marcosdxt/allprint-capboard/Outputs/BOM/Bill of Materials-ALLPRINT-CAPBOARD-677512.xlsx

Comment | Description | Designator | Footprint | LibRef | Quantity | LCSC
10uF/50V | 50V 10uF X5R ±10% 1206 Multilayer Ceramic Capacitors MLCC - SMD/SMT ROHS | C1, C16, C17, C46, C49 | CAP-0805 | CAP-10uF/50V-0805-X5R-MLCC | 5 | C13585
100nF/50V | 50V 100nF X7R ±10% 0603 Multilayer Ceramic Capacitors MLCC - SMD/SMT ROHS | C2, C3, C4, C5, C6, C12, C15, C18, C22, C24, C28, C29, C31, C37, C40, C48, C52, C71 | CAP-0603 | CAP-100nF/50V-0603-X7R-MLCC | 18 | C14663
1uF/25V | 25V 1uF X7R ±10% 0603 Multilayer Ceramic Capacitors MLCC - SMD/SMT ROHS | C7, C9 | CAP-0603 | CAP-1uF/25V-0603-X7R-MLCC | 2 | C29936
10nF/50V | 50V 10nF X7R ±10% 0603 Multilayer Ceramic Capacitors MLCC - SMD/SMT ROHS | C8, C19, C55, C61, C64, C66, C68, C70 | CAP-0603 | CAP-10nF/50V-0603-X7R-MLCC | 8 | C1589
15pF/50V | 50V 15pF NP0 ±5% 0603 Ceramic Capacitors RoHS | C10, C11 | CAP-0603 | CAP-15pF/50V-0603-NP0-MLCC | 2 | C107037
39pF/50V | 50V 39pF X7R ±10% 0603 Multilayer Ceramic Capacitors MLCC - SMD/SMT ROHS | C13, C14, C30, C32, C33, C34, C35, C36, C54, C60, C63, C65, C67, C69 | CAP-0603 | CAP-39pF/50V-0603-X7R-MLCC | 14 | C107049
10uF/16V | 16V 10uF X5R ±20% 0603 Multilayer Ceramic Capacitors MLCC - SMD/SMT ROHS | C20, C21, C23 | CAP-0603 | CAP-10uF/16V-0603-X5R | 3 | C92487
10uF/25V | 25V 10uF X5R ±10% 0805 Ceramic Capacitors ROHS | C25, C26, C27 | CAP-0805 | CAP-10uF/25V-0805-X5R-MLCC | 3 | C15850
220nF/50V | 50V 220nF X7R ±10% 0603 Multilayer Ceramic Capacitors MLCC - SMD/SMT ROHS | C38, C44, C45, C57, C58 | CAP-0603 | CAP-220nF/50V-0603-X7R-MLCC | 5 | C64705
1000uF | 1000uF 35V ±20% Through Hole,D10xL20mm Aluminum Electrolytic Capacitors RoHS | C39 | CAP-ELET-D10-H20 | CAP-1000uF-35V-D10-H20 | 1 | C398835
470nF/50V | 50V 470nF X7R ±10% 0603 Multilayer Ceramic Capacitors MLCC - SMD/SMT ROHS | C41, C50, C53 | CAP-0603 | CAP-470nF/50V-0603-X7R-MLCC | 3 | C513577
22nF/100V | 100V 22nF X7R ±10% 0805 Ceramic Capacitors RoHS | C42 | CAP-0805 | CAP-22nF/100V-0805-X7R-MLCC | 1 | C107137
1nF/100V | 100V 1nF NP0 ±5% 0805 Ceramic Capacitors RoHS | C43, C47, C56, C59 | CAP-0805 | CAP-1nF/100V-0805-NP0-MLCC | 4 | C326940
2.2nF/50V | 50V 2.2nF X7R ±10% 0603 Ceramic Capacitors RoHS | C51, C62 | CAP-0603 | CAP-2.2nF/50V-0603-X7R-MLCC | 2 | C107082
SM712.TCT-ES | 400W@8/20us Bidirectional SOT-23 ESD and Surge Protection (TVS/ESD) ROHS | D1, D2, D7, D8 | SOT23-3 | SM712.TCT-ES | 4 | C22363671
SMBJ15CA | 24.6A 600W@8/20us 24.4V 19.2V Bidirectional 15V SMB(DO-214AA) ESD and Surge Protection (TVS/ESD) ROHS | D3 | DO214-AA | SMBJ15CA | 1 | C2760879
SMBJ26CA | 28.9V 26V 42.1V 14.2A 600W Bidirectional DO-214AA(SMB) TVS Diodes RoHS | D4, D26 | DO214-AA | SMBJ26CA | 2 | C908854
MBRS360BT3G | 125A 60V 630mV@3A 3A SMB(DO-214AA) Single Diodes RoHS | D5 | DO214-AA | DIODE-SCHOTTKY-60V-3A-MBRS360BT3G | 1 | C59027
SMBJ5.0A | 65.3A 600W 9.2V 6.4V Unidirectional 5V DO-214AA TVS Diodes RoHS | D6 | DO214-AA | SMBJ5.0A | 1 | C83333
BZT52C15 | DIODO ZENER 15V-500mW-SOD123 | D9, D11 | SOD123 | BZT52C15 | 2 | C266569
SMAJ26A | 28.9V 26V 9.5A 42.1V 400W Unidirectional DO-214AC(SMA) TVS Diodes RoHS | D10, D12 | DO214-AC (SMA) | SMAJ26A | 2 | C2848697
1N4148 | 1A 4ns 75V Independent 1V@50mA 150mA SOD-123 Single Diodes RoHS | D13, D31, D33, D35, D37, D39, D41 | SOD123 | 1N4148 | 7 | C241939
1N5819HW-7-F | 25A 1 Independent 40V 450mV@1A 1A SOD-123 Single Diodes RoHS | D14, D15, D16, D17, D18, D19 | SOD123 | 1N5819HW-7-F | 6 | C82544
1N4007-M7 | C20754788 | D20, D21, D22, D23, D24, D25 | SMA | 1N4007-M7 | 6 | C20754788
MBRS360BT3G | Independent 60V 700mV@1A 1A SOD-123FL Single Diodes RoHS | D27, D28, D29, D30 | SOD-123FL | DIODE-SCHOTTKY-60V-1A-DSK16 | 4 | C48676
BAT54S | 30V Dual 200mA 800mV@100mA SOT-23 Schottky Barrier Diodes (SBD) ROHS | D32, D34, D36, D38, D40, D42 | SOT23-3 | BAT54S | 6 | C916425
JFC2410-2100FS | 125V Surface Mount Fuse 10A 2410 Fuses RoHS | F1 | FUSE-2410 | FUSE-125V-10A-2410 | 1 | C136374
JFC2410-1500TS | 250V Surface Mount Fuse 5A 2410 Fuses RoHS | F2 | FUSE-2410 | FUSE-250V-5A-2410 | 1 | C136387
BLM18PG121SN1D | FERRITE BEAD 120Ω 0603 1LN | FB1, FB2, FB3, FB4, FB5, FB6, FB7, FB8 | RES-0603 | BLM18PG121SN1D | 8 | C14709
FIDUCIAL |  | FD1, FD2, FD3 | FIDUCIAL | FIDUCIAL | 3
STLZ950/3G-5.08-V-GREEN_1 | CONECTOR PHOENIX MECANO 3 VIAS PASSO 5,08mm VERDE 180º | J1 | STLZ950/3G-5.08-V | STLZ950/3G-5.08-V-GREEN | 1
DSHP04TS-S | 4 24V 25mA SPST 3,000 Cycles Black Slide, Recessed SMD-8P,6.7x5.4mm DIP Switches/SIP Switches ROHS | J2 | SW-SMD_8P-L6.7-W5.4-P1.27-LS8.5 | DSHP04TS-S | 1 | C319050
MCFPL-08 | CONECTOR-METALTEX-PASSO-3mm-90 GRAUS MONTAGEM PLACA-COMPATIVEL MICROFIT-8VIAS 5A-250VCA | J3, J6 | MCFPL-08 | MCFPL-08 | 2
MCFPL-04 | CONECTOR-METALTEX-PASSO-3mm-90 GRAUS MONTAGEM PLACA-COMPATIVEL MICROFIT-4VIAS 5A-250VCA | J4 | MCFPL-04 | MCFPL-04 | 1
MCFPL-12 | CONECTOR-METALTEX-PASSO-3mm-90 GRAUS MONTAGEM PLACA-COMPATIVEL MICROFIT-12VIAS 5A-250VCA | J5 | MCFPL-12 | MCFPL-12 | 1
MCFPL-06 | CONECTOR-METALTEX-PASSO-3mm-90 GRAUS MONTAGEM PLACA-COMPATIVEL MICROFIT-6VIAS 5A-250VCA | J7 | MCFPL-06 | MCFPL-06 | 1
MCFPL-10 | CONECTOR-METALTEX-PASSO-3mm-90 GRAUS MONTAGEM PLACA-COMPATIVEL MICROFIT-10VIAS 5A-250VCA | J8 | MCFPL-10 | MCFPL-10 | 1
PEMC1-04 | CONECTOR PASSO 2,5mm 250VCA 3A 10mOHMS | J9 | PEMC1-04 | PEMC1-04 | 1
PEMC1-02 | CONECTOR PASSO 2,5mm 250VCA 3A 10mOHMS | J10 | PEMC1-02 | PEMC1-02 | 1
BPDC-06 | BARRA DE PINOS DUPLA 2,54mm 6 VIAS 180º | K1 | BPDC-06 | BPDC-06 | 1
AX1RC2 | RELÉ-METALTEX-BOBINA 12V-15A-SPDT | K2 | METALTEX-AX1 | AX1RC2 | 1
YLED0603R | 25mA 120mcd 620nm~625nm Red 1.8V~2.4V 0603 LED Indication - Discrete RoHS | L1, L2 | LED-SMD-0603 | D-LED-SMD-PKG@0603-RED | 2 | C19171390
22uH | 2.6A 22uH ±20% 110mΩ SMD,7.2x6.6mm Fixed Inductors RoHS | L3 | INDUTOR-6672 | FIXED-INDUCTOR-SMD-22uH-7.2X6.6mm-2.6A-110mΩ | 1 | C5189963
RL0603A360K | 78V 28V 21V 33.6V~42V 0603 Varistors, MOVs RoHS | MOV1, MOV2, MOV3, MOV4, MOV5, MOV6 | MOV-0603 | MOV-RL0603A360K-SMD | 6 | C2935568
JK-nSMD050-30 | 30V 500mA 100A 1A 150mΩ 1206 PTC Resettable Fuses ROHS | PTC1, PTC6, PTC7, PTC8, PTC9, PTC10, PTC11, PTC12, PTC13 | PTC-1206 | PTC-FUSE-30V-500mA-1206 | 9 | C720075
BSMD0603-001-60V | 60V 10mA 20A 50mA 15Ω 0603 PTC Resettable Fuses ROHS | PTC2, PTC3, PTC4, PTC5, PTC14 | PTC-0603 | PTC-FUSE-60V-10mA-0603 | 5 | C914088
SP40N02HTH | 40V 130A 2.5mΩ@10V 125W TO-252 Single FETs, MOSFETs RoHS | Q1 | TO-252-2 | TRAN-MOSFET-N-CHAN-40V-130A-DPAK | 1 | C41354884
BC856 | 65V 220@2mA,5V 250mW 100mA PNP SOT-23 Bipolar (BJT) ROHS | Q2 | SOT23-3 | TRANSISTOR-BC856B,215 | 1 | C109310
BC846 | 65V 200@10mA,5V 250mW 100mA NPN SOT-23 Bipolar (BJT) ROHS | Q3, Q5, Q7, Q8 | SOT23-3 | TRANSISTOR-BC846B,215-SOT23 | 4 | C87062
SI2319 | P-Channel 40V 5A 1.4W Surface Mount SOT-23 | Q4, Q6 | SOT23-3 | SI2319 | 2 | C5337197
AO4882 | 40V 40A 2.4V 2 N-Channel SOIC-8 Single FETs, MOSFETs RoHS | Q9, Q10, Q11, Q12 | SOIC-08 | AO4882 | 4 | C477943
10K | 100mW Thick Film Resistor 75V ±100ppm/℃ ±1% 10kΩ 0603 Chip Resistor - Surface Mount ROHS | R1, R2, R13, R14, R15, R21, R25, R26, R27, R28, R29, R37, R38, R42, R43, R44, R45, R47, R49, R51, R53, R55, R57 | RES-0603 | RES-10K-1%-100mW-0603 | 23 | C98220
1K | 100mW Thick Film Resistor 75V ±100ppm/℃ ±1% 1kΩ 0603 Chip Resistor - Surface Mount ROHS | R3, R4, R5, R6, R11, R12, R58, R59, R76, R82, R90, R95, R99, R103, R106 | RES-0603 | RES-1K-1%-100mW-0603 | 15 | C22548
10R | 100mW Thick Film Resistor 75V ±1% ±400ppm/℃ 10Ω 0603 Chip Resistor - Surface Mount ROHS | R7, R62, R63, R70, R71, R78, R79, R80, R84, R85, R86, R93, R97, R101, R105 | RES-0603 | RES-10R-1%-100mW-0603 | 15 | C22859
0R | 100mW 0Ω 75V Thick Film Resistor ±5% 0603 Chip Resistor - Surface Mount RoHS | R8, R61, R64 | RES-0603 | RES-0R-1%-100mW-0603 | 3 | C95177
0R | 100mW Thick Film Resistor 75V ±100ppm/℃ ±1% 0R Chip Resistor - Surface Mount ROHS | R9, R10 | RES-0805 | RES-0R-1%-125mW-0805 | 2 | C17477
2.2K | 125mW 2.2kΩ 150V ±100ppm/℃ Thick Film Resistor ±1% 0805 Chip Resistor - Surface Mount ROHS | R16, R19, R36, R41, R46, R48, R50, R52, R54, R56 | RES-0805 | RES-2.2K-1%-125mW-0805 | 10 | C2907234
1K | 125mW Thick Film Resistor 150V ±100ppm/℃ ±1% 1kΩ 0805 Chip Resistor - Surface Mount ROHS | R17, R18 | RES-0805 | RES-1K-1%-125mW-0805 | 2 | C17513
0R | 0Ω 250mW 200V Thick Film Resistor ±1% 1206 Chip Resistor - Surface Mount RoHS | R20 | RES-1206 | RES-0R-1%-250mW-1206 | 1 | C137394
49.9K | 100mW 49.9kΩ 75V ±100ppm/℃ Thick Film Resistor ±1% 0603 Chip Resistor - Surface Mount ROHS | R22 | RES-0603 | RES-49.9K-1%-100mW-0603 | 1 | C114624
100K | 100mW Thick Film Resistor 75V ±100ppm/℃ ±1% 100kΩ 0603 Chip Resistor - Surface Mount ROHS | R23, R34, R39 | RES-0603 | RES-100K-1%-100mW-0603 | 3 | C14675
9.53K | 100mW 9.53kΩ 75V ±100ppm/℃ Thick Film Resistor ±1% 0603 Chip Resistor - Surface Mount ROHS | R24 | RES-0603 | RES-9.53K-1%-100mW-0603 | 1 | C2960722
100R | 100mW Thick Film Resistor 75V ±100ppm/℃ ±1% 100Ω 0603 Chip Resistor - Surface Mount ROHS | R30, R32, R77, R83, R92, R96, R100, R104 | RES-0603 | RES-100R-1%-100mW-0603 | 8 | C105588
120R | 120Ω ±1% 500mW 1206 Thick Film Resistor | R31, R33 | RES-1206 | RES-120R-1%-500mW-1206 | 2 | C5713417
2K | 250mW Thick Film Resistor 200V ±100ppm/℃ ±5% 2kΩ 1206 Chip Resistor - Surface Mount ROHS | R35, R40 | RES-1206 | RES-2K-1%-250mW-1206 | 2 | C2907466
4.7R | 125mW 4.7Ω 150V ±200ppm/℃ Thick Film Resistor ±1% 0805 Chip Resistor - Surface Mount RoHS | R60 | RES-0805 | RES-4.7R-1%-125mW-0805 | 1 | C137513
1R | 1Ω 100mW 75V ±200ppm/℃ Thick Film Resistor ±5% 0603 Chip Resistor - Surface Mount RoHS | R65, R66, R67, R69 | RES-0603 | RES-1R-1%-100mW-0603 | 4 | C2907116
2.2R | 2.2Ω 100mW 75V ±200ppm/℃ Thick Film Resistor ±5% 0603 Chip Resistor - Surface Mount RoHS | R68 | RES-0603 | RES-2.2R-1%-100mW-0603 | 1 | C2930032
47R | 100mW Thick Film Resistor 75V ±100ppm/℃ ±1% 47Ω 0603 Chip Resistor - Surface Mount ROHS | R72, R74, R87, R91 | RES-0603 | RES-47R-1%-100mW-0603 | 4 | C114623
75mΩ | 3W 75mΩ Current Sense Resistor ±50ppm/℃ ±1% 2512 Current Sense Resistors RoHS | R73, R88 | RES-2512 | RES-75mΩ-1%-3W-2512 | 2 | C49164914
10K | 100mW Thick Film Resistor 75V ±100ppm/℃ ±1% 10K Chip Resistor - Surface Mount ROHS | R75, R81, R89, R94, R98, R102 | RES-0805 | RES-10K-1%-125mW-0805 | 6 | C84376
STM32G431CBT6 |  | U1 | LQFP-48_L7.0-W7.0-P0.50-LS9.0-BL | STM32G431CBT6 | 1 | C529355
EL3H7(C)(TA)-G | 80V 3.75kV 50mA 200mV@10mA,1mA 6V 1.2V DC SSOP-4-1.27mm Transistor, Photovoltaic Output Optoisolators ROHS | U2, U15 | SSOP-4 | EL3H7(C)(TA)-G | 2 | C92243
SN74HC04PWR | 2V~6V 16ns@6V,50pF 2uA 6 1 TSSOP-14 Gates and Inverters RoHS | U3, U9, U13, U14 | TSSOP-14 | SN74HC04PWR | 4 | C6810
LM74700QDBVRQ1 | Low IQ Battery Reverse Protection Ideal Diode Controller | U4 | SOT23-6 | IC-OR-CONTROLLER-LM74700QDBVRQ1 | 1 | C2941042
AOZ1282CI | Step-down type Adjustable 800mV~36V 1.2A 4.5V~36V SOT-23-6 DC-DC Converters ROHS | U5 | SOT23-6 | AOZ1282CI | 1 | C111916
LM1117S-3.3 | LM1117S-3.3 | U6 | SOT223 | LM1117S-3.3 | 1 | C126027
MAX485ESA | Low-Power, Slew-Rate-Limited RS-485/RS-422 Transceivers | U7, U8 | SOIC-08 | MAX485ESA | 2 | C5279041
PCF8574M/TR | 8 I2C SOP-16-150mil I/O Expanders RoHS | U10 | SOIC-16-3D | PCF8574M/TR | 1
ULN2003ADR | 50V 500mA SOIC-16 Bipolar Transistor Arrays RoHS | U11 | SOIC-16-3D | ULN2003ADR | 1 | C7512
TMC5160A-TA-T |  | U12 | TQFP-48_L7.0-W7.0-P0.50-LS9.0-BL-EP | TMC5160A-TA-T | 1 | C516354
CF4008M00012001 | Crystal Oscillator 12pF SMD3225-4P Crystals RoHS | X1 | TAXM8M4RDBCCT2T | XTAL-8MHZ-3225-SMD | 1 | C7294546
