marcosdxt/allprint-capboard/Outputs/ExportSTEP/ALLPRINT-CAPBOARD-677512.step

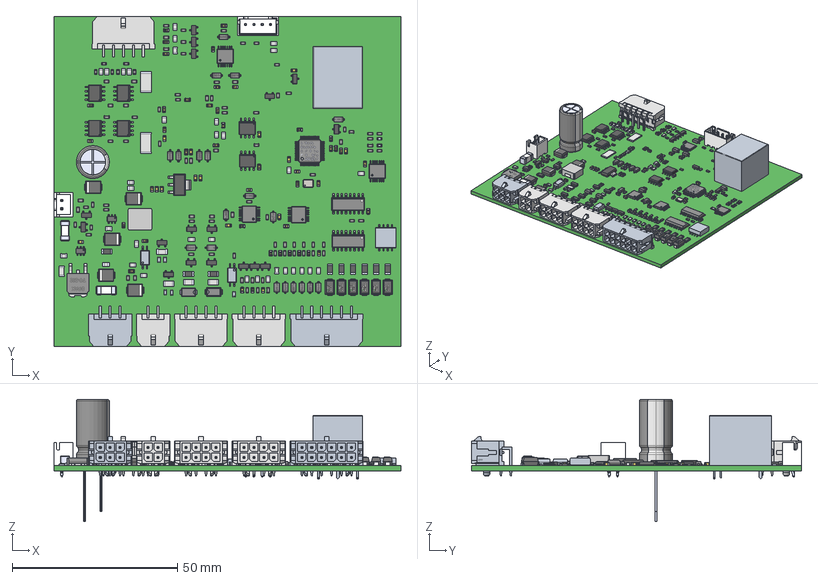
[picture p1: CAD file, 2026-05-05]
Outputs/ExportSTEP/ALLPRINT-CAPBOARD-677512.step
105.0 x 100.0 x 37.0 mm
CircuitWorks-SOT-23 x 17
CircuitWorks-CAPACITOR 0805 x 13
User Library-TSSOP14-1 x 4
max485esa_t x 6
CircuitWorks-RESISTOR 1206 x 5
mf-fsmf050x-2 x 5
LG_Q396_20151026_geometry x 2
CircuitWorks-RESISTOR 0805 x 21
CircuitWorks-RESISTOR 2512 x 2
EZJ-Z1V420FA x 6
B4B-XH-A-LF--SN---3DModel-STEP-418109
0451005.MRL x 2
User Library-SOD-123 x 19
User Library-DO-214AA_SMB x 5
EEUEB1H331
User Library-SOIC-16-3 x 2
el3h7-g x 2
SMAJ26A x 2
NANOSMDC050F_13.2-2 x 9
User Library-STM32L053C8T6
User Library-3225-1
lm1117impx-5_0_nopb
User Library-SOT23-6-2 x 2
User Library-DPAK_TO-252AA
User Library-L_ShouHan_CYA0630
RELǭAX
B2B-XH-A-LF--SN---3DModel-STEP-269445
User Library-MDD SS510 SMA x 6
