marcosdxt/allprint-capboard/Outputs/Project_Outputs.PDF

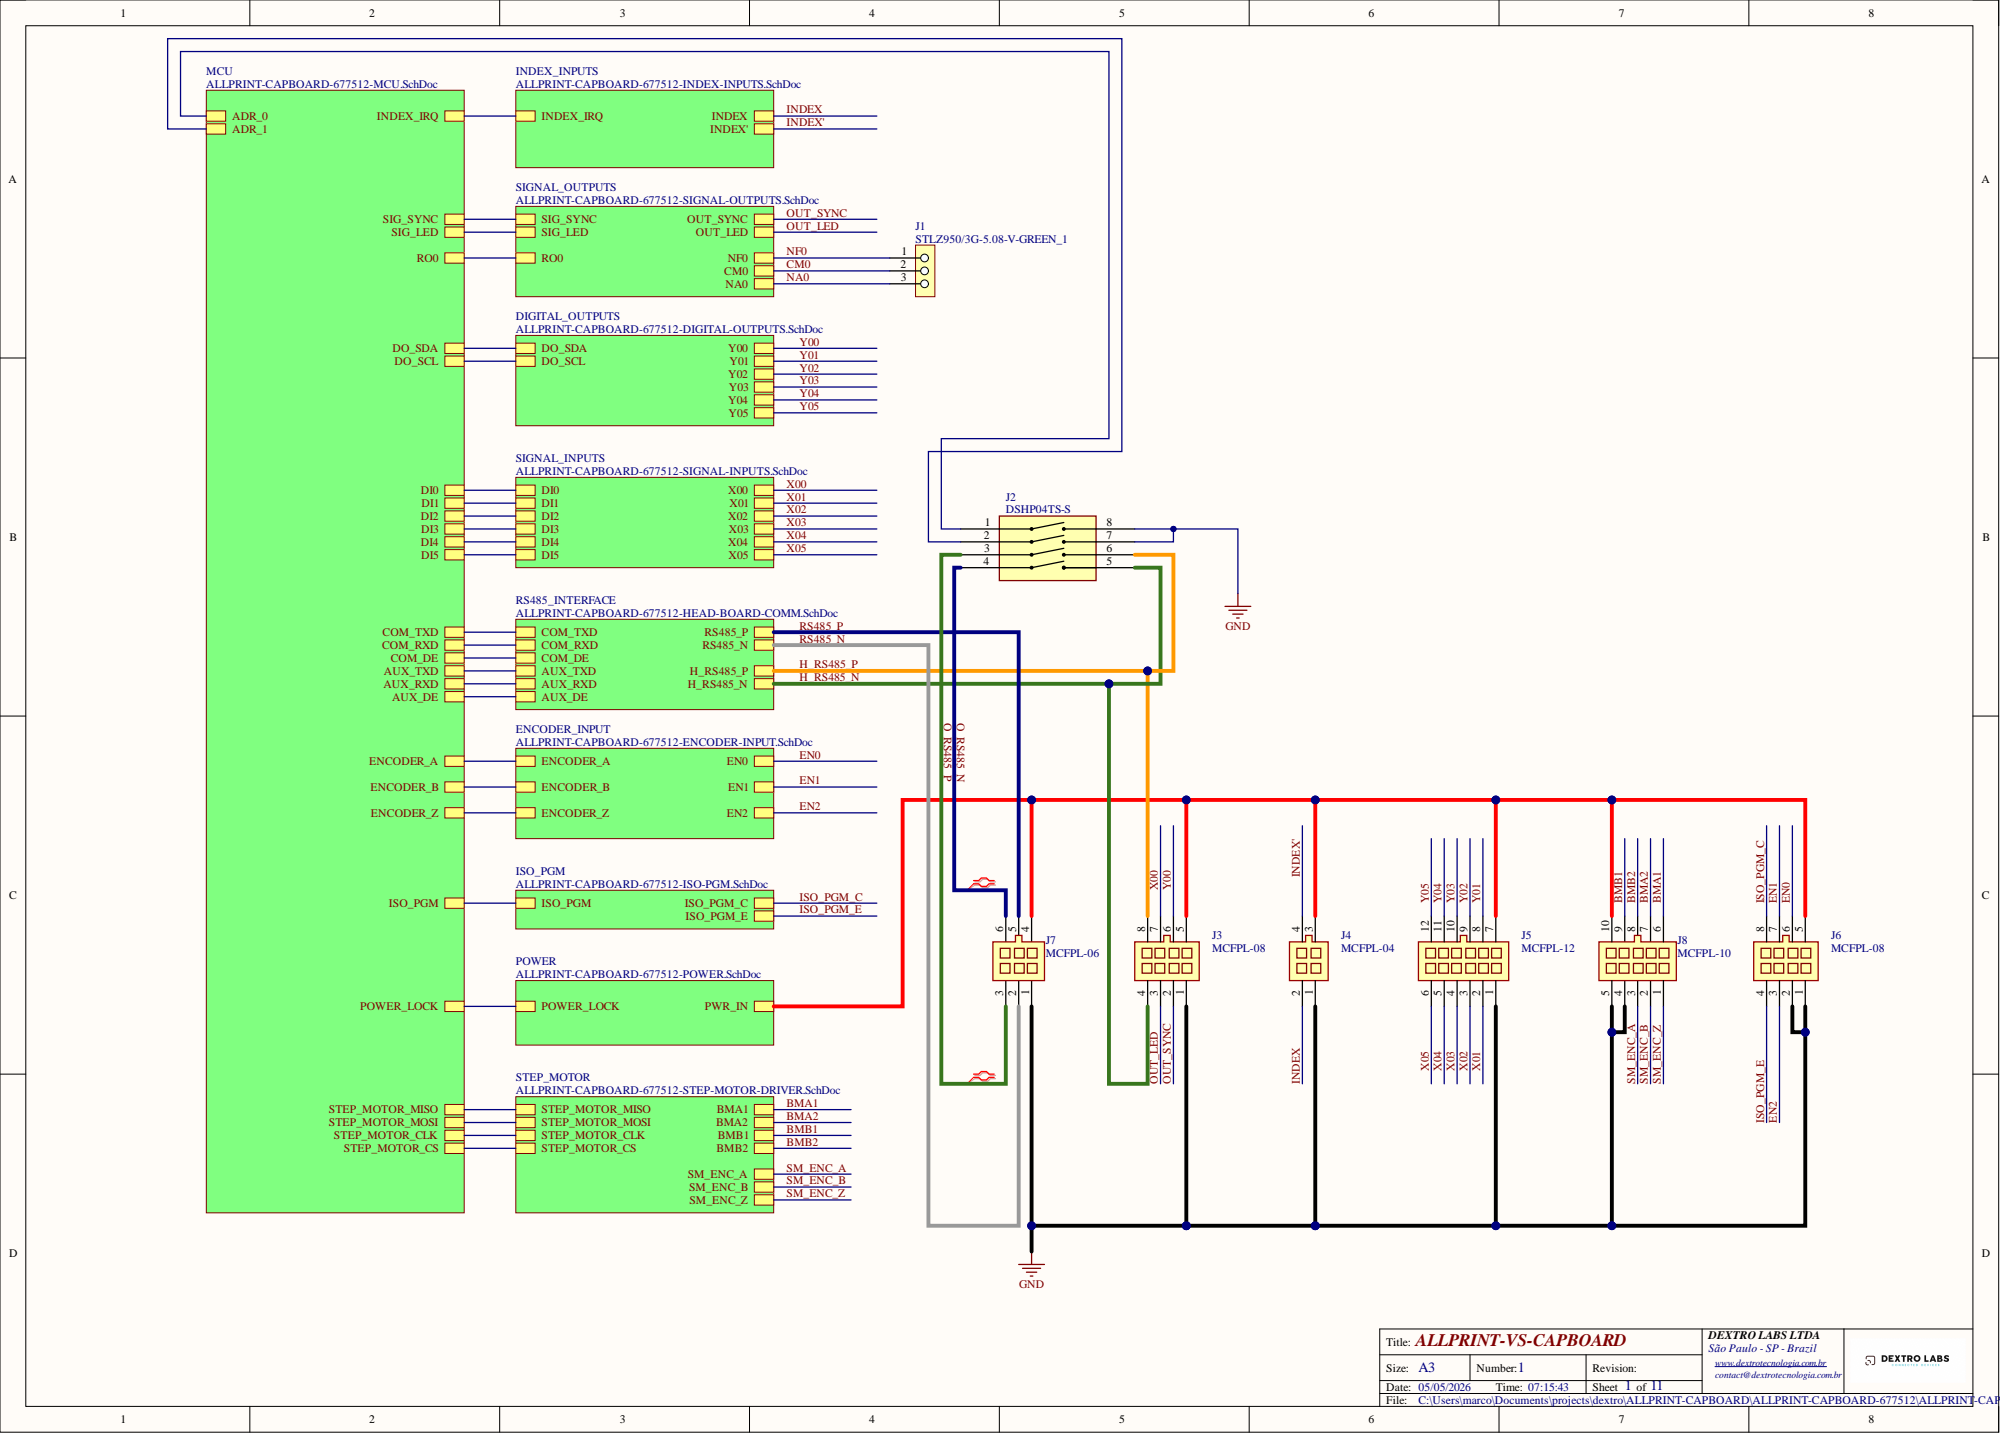
[picture p2: page 1]

MCU
ALLPRINT-CAPBOARD-677512-MCU.SchDoc

INDEX_INPUTS
ALLPRINT-CAPBOARD-677512-INDEX-INPUTS.SchDoc

SIGNAL_OUTPUTS
ALLPRINT-CAPBOARD-677512-SIGNAL-OUTPUTS.SchDoc

SIGNAL_INPUTS
ALLPRINT-CAPBOARD-677512-SIGNAL-INPUTS.SchDoc

H_RS485_P
H_RS485_N

EN2 ISO_PGM_C ISO_PGM_E

ISO_PGM
ALLPRINT-CAPBOARD-677512-ISO-PGM.SchDoc

POWER
ALLPRINT-CAPBOARD-677512-POWER.SchDoc

DEXTRO LABS LTDA
São Paulo - SP - Brazil
www.dextrotecnologia.com.br
contact@dextrotecnologia.com.br

C:\Users\marco\Documents\projects\dextro\ALLPRINT-CAPBOARD\ALLPRINT-CAPBOARD-677512\ALLPRINT-CAPBOARD-677512-GENERAL.SchDoc

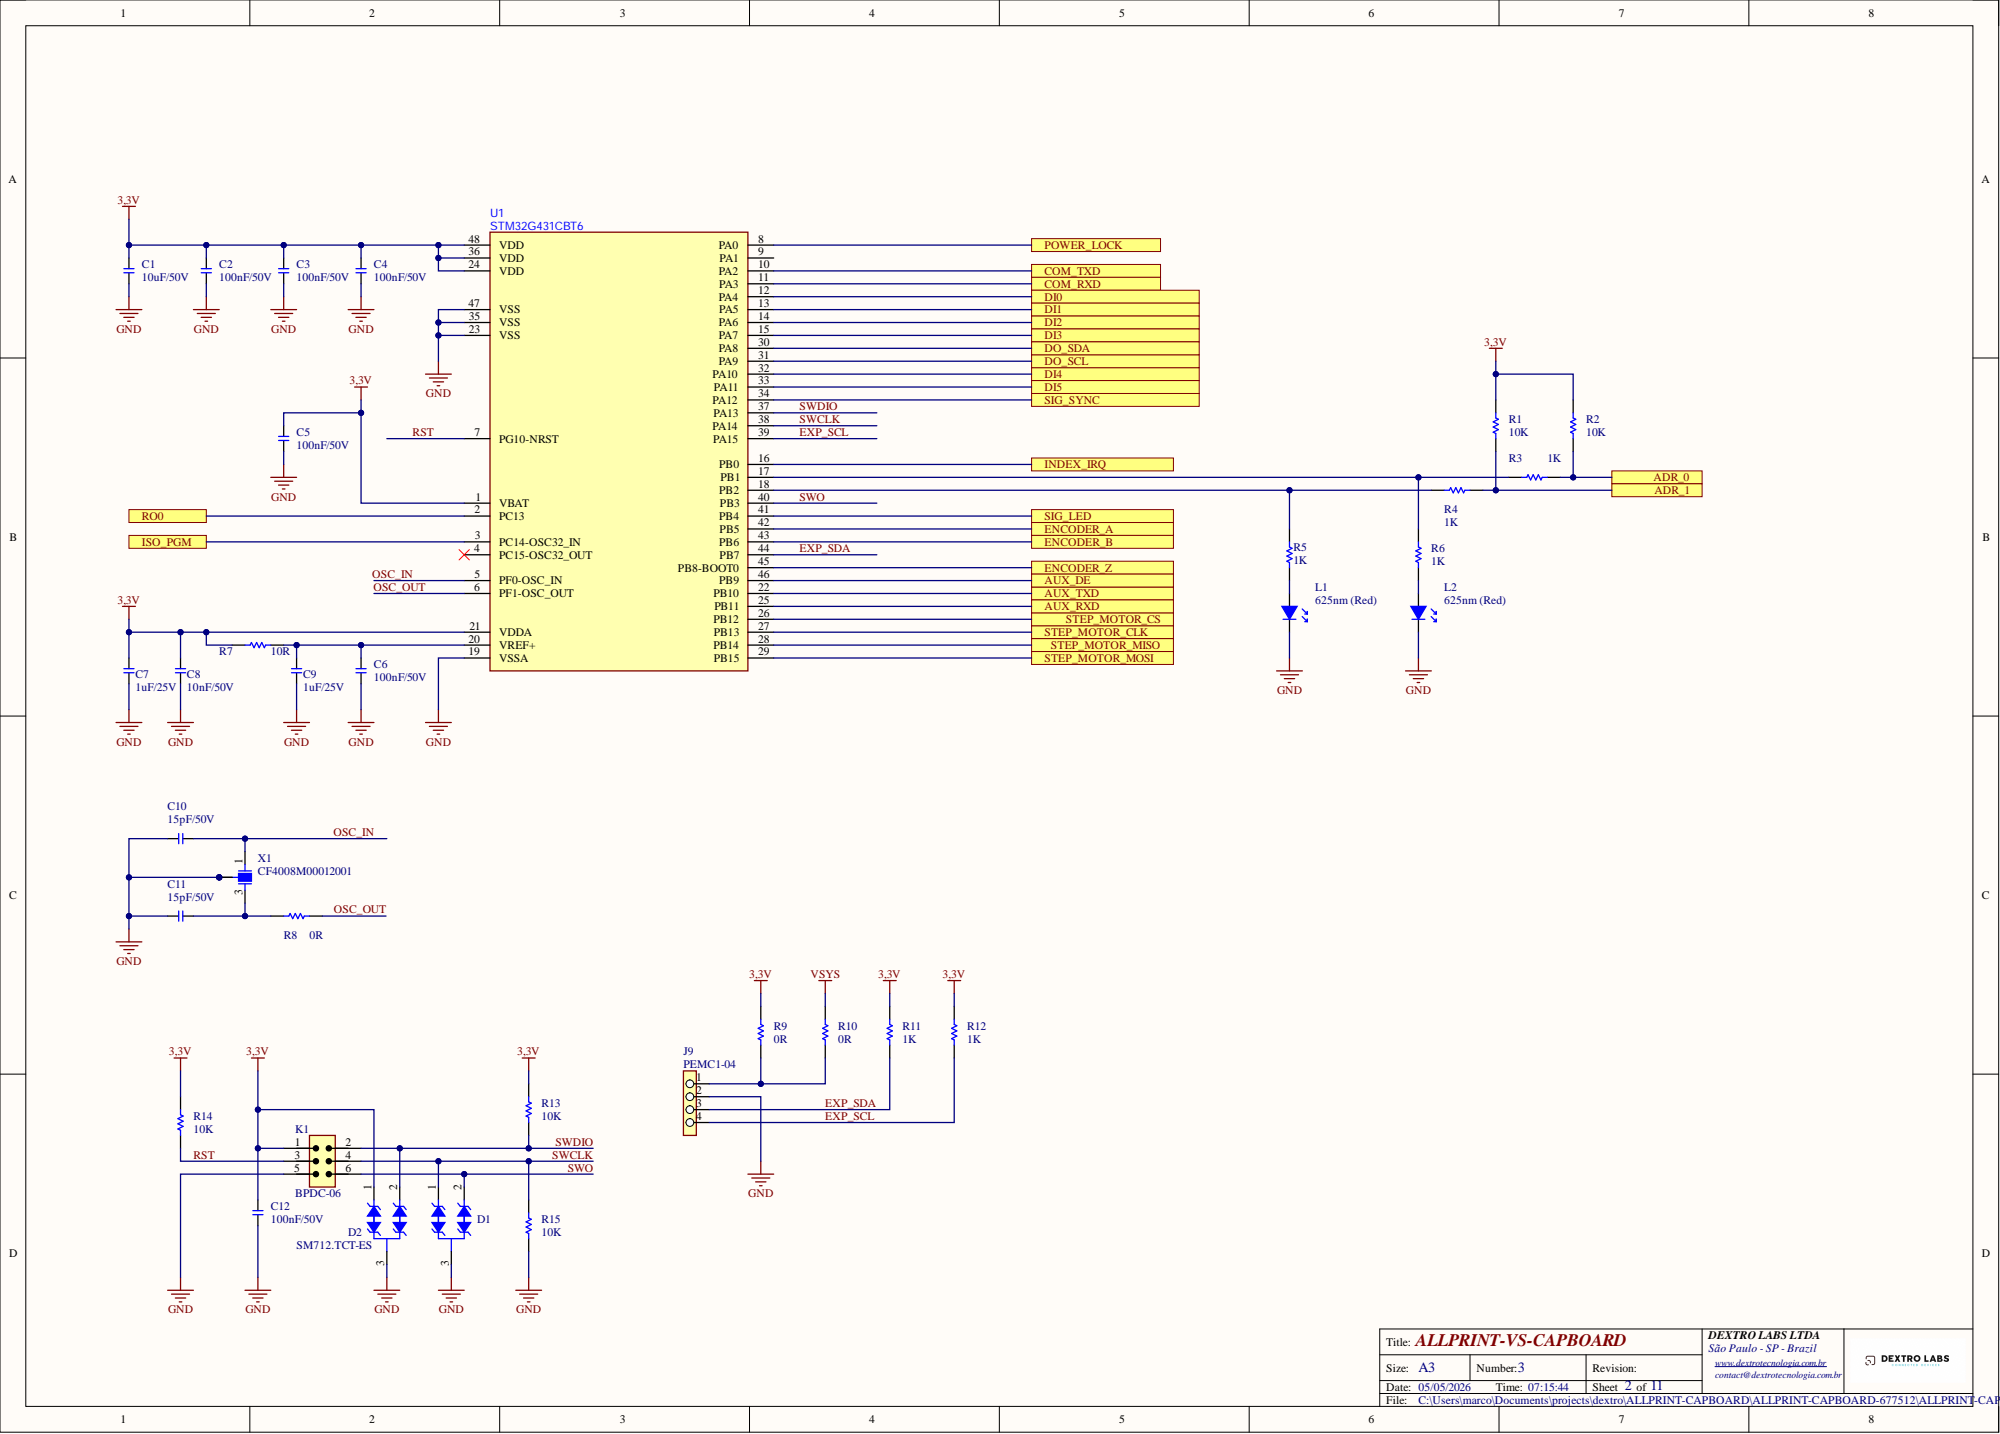
[picture p3: page 2]

4 | EXP_SCL

C:\Users\marco\Documents\projects\dextro\ALLPRINT-CAPBOARD\ALLPRINT-CAPBOARD-677512\ALLPRINT-CAPBOARD-677512-MCU.SchDoc

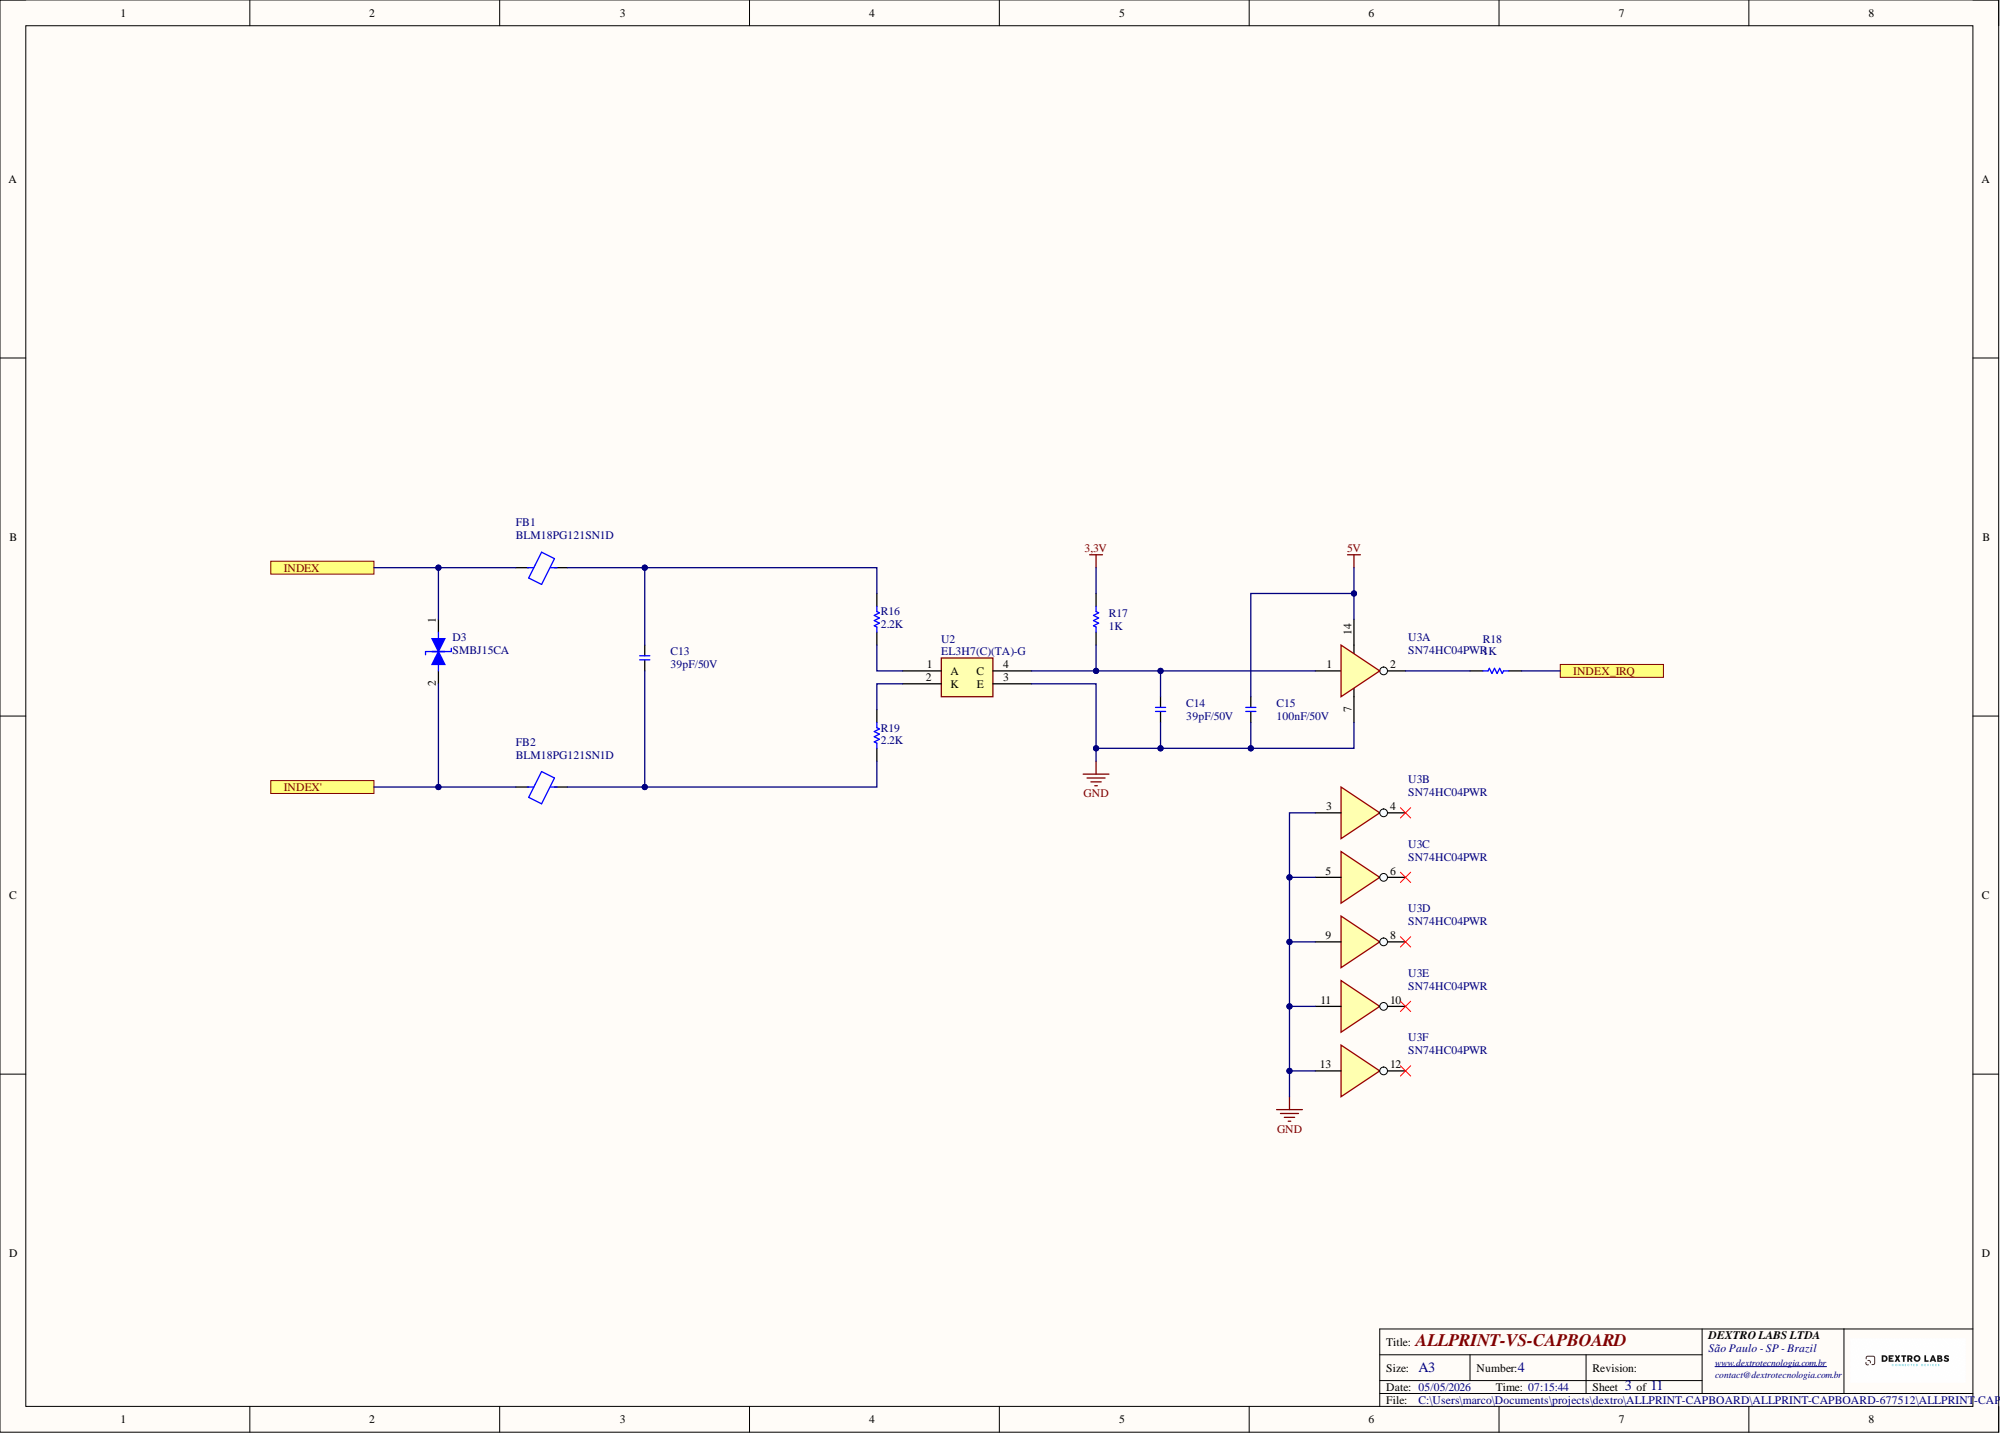
[picture p4: page 3]

C:\Users\marco\Documents\projects\dextro\ALLPRINT-CAPBOARD\ALLPRINT-CAPBOARD-677512\ALLPRINT-CAPBOARD-677512-INDEX-INPUTS.SchDoc

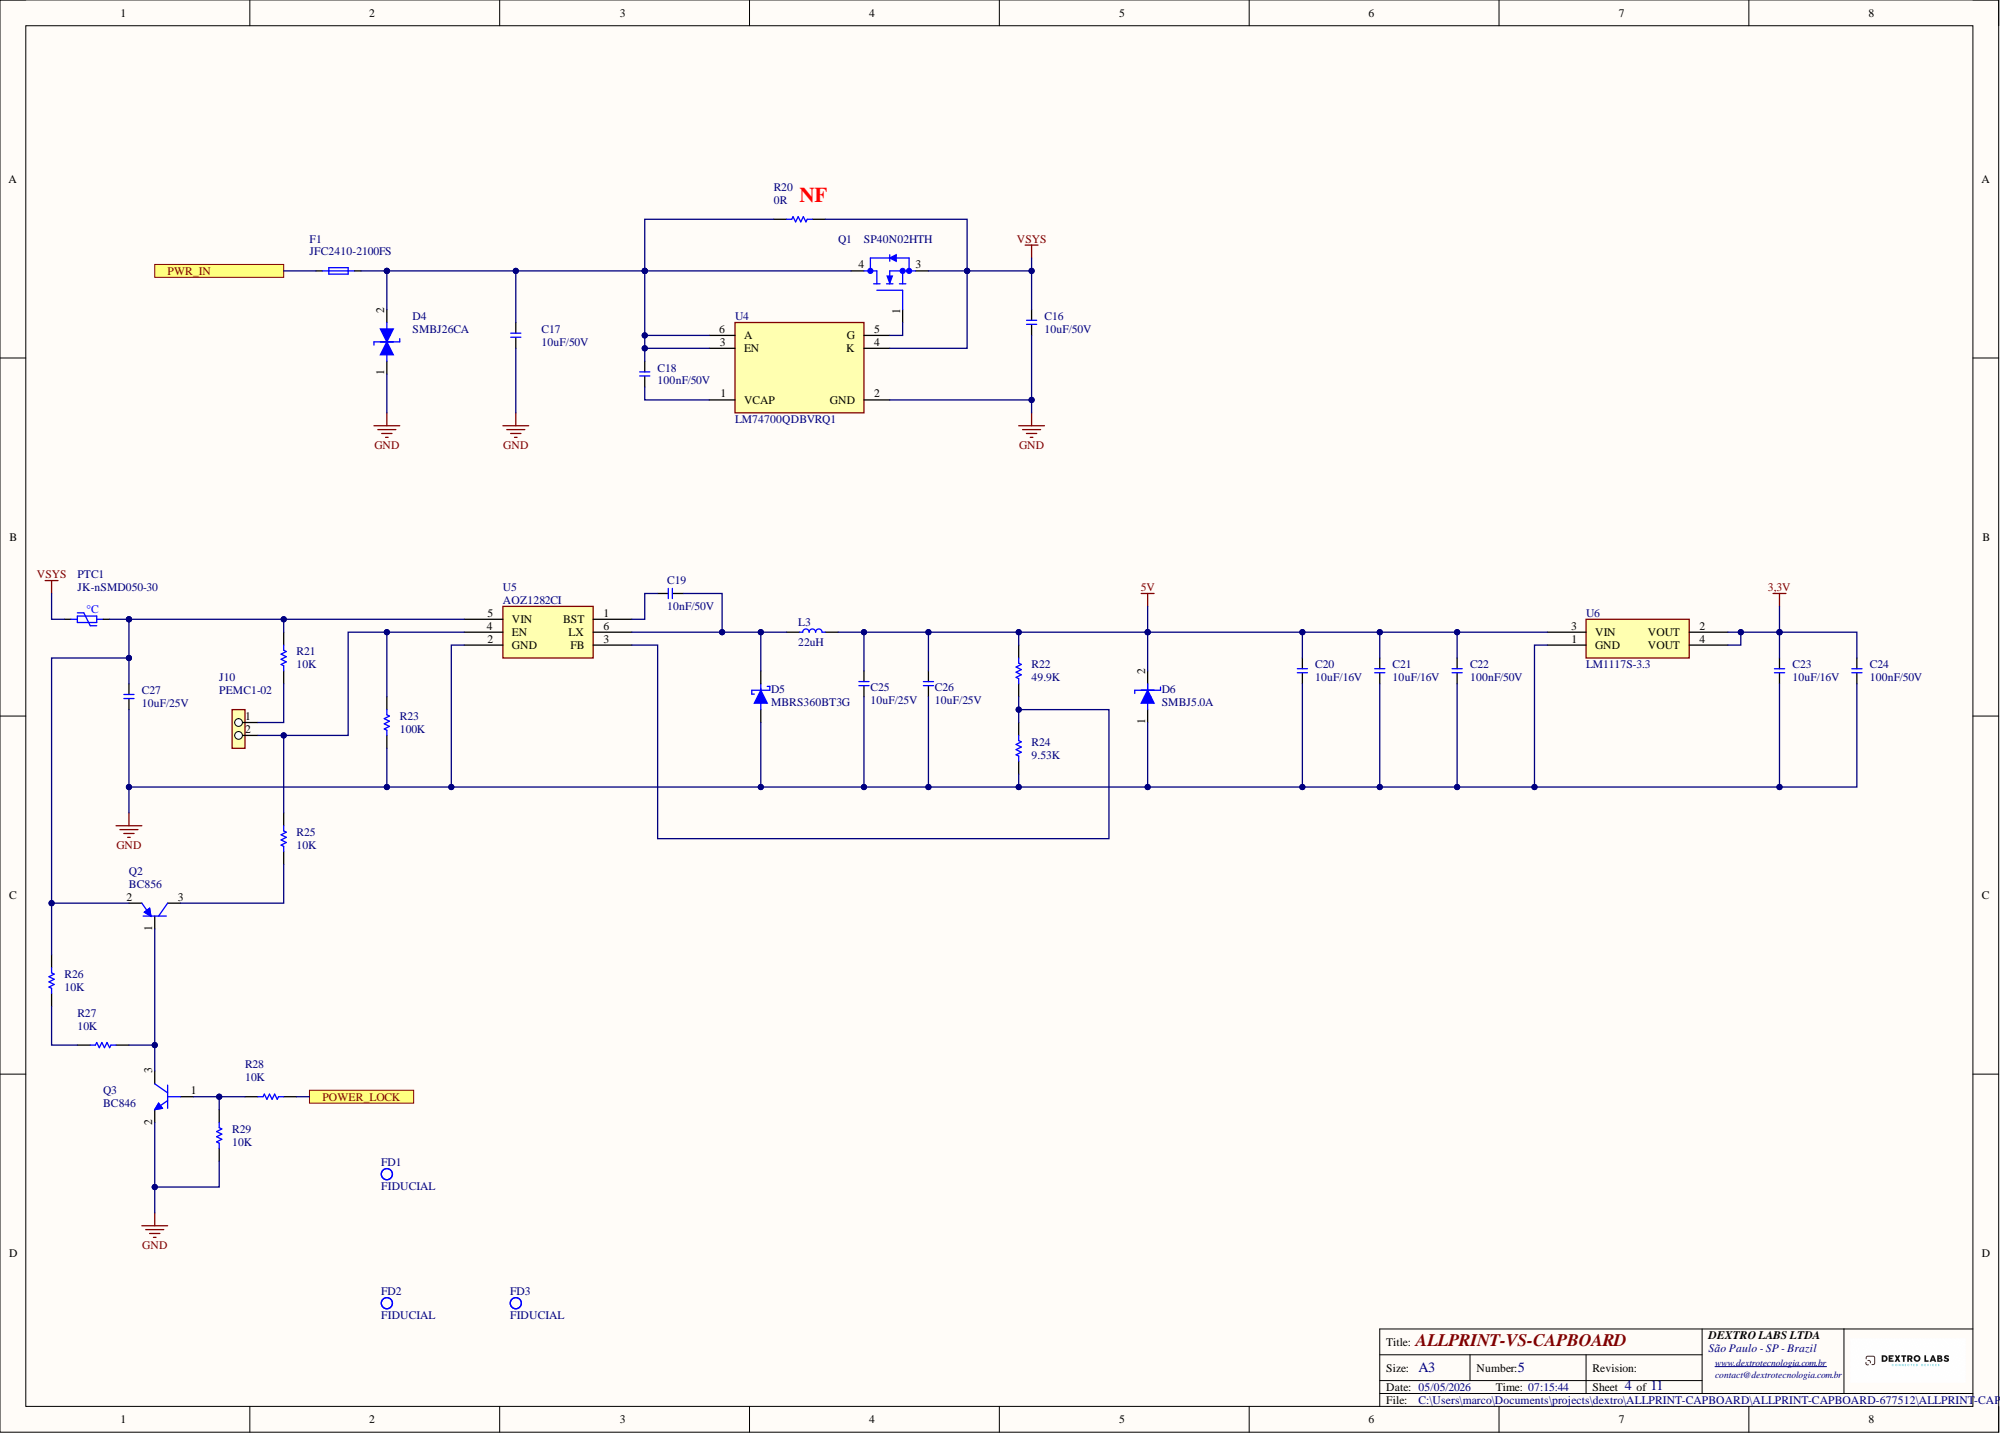
[picture p5: page 4]

C:\Users\marco\Documents\projects\dextro\ALLPRINT-CAPBOARD\ALLPRINT-CAPBOARD-677512\ALLPRINT-CAPBOARD-677512-POWER.SchDoc

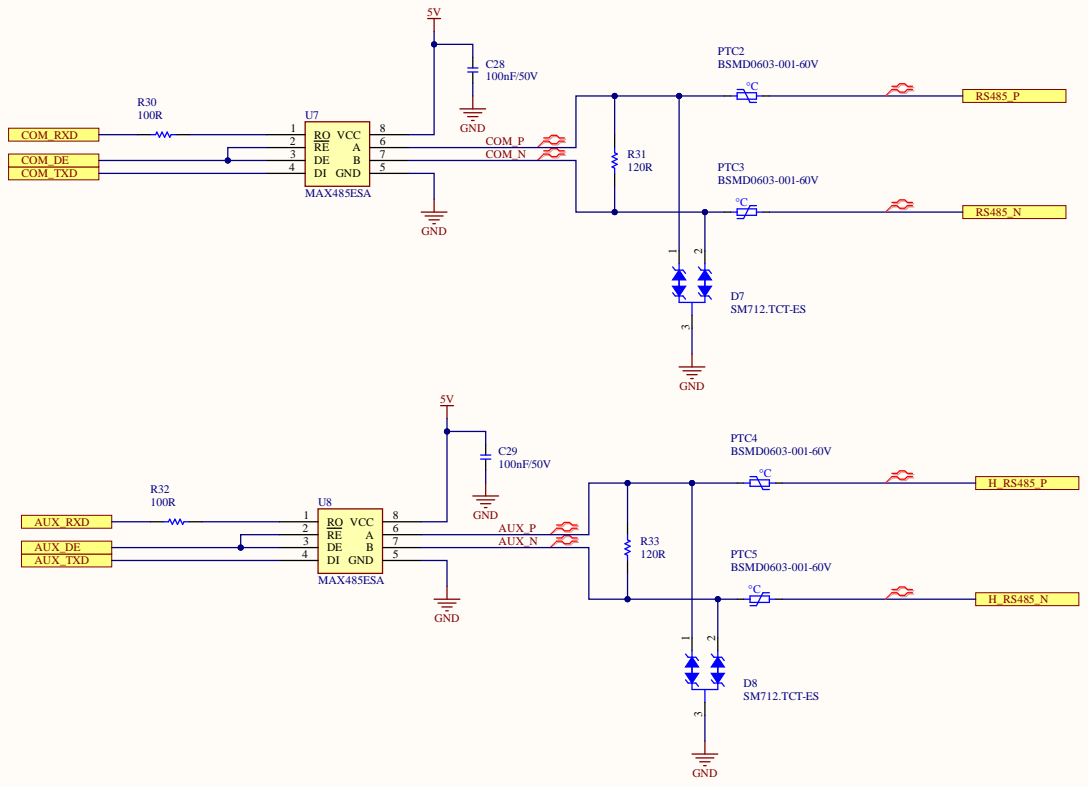
[picture p6: page 5]

C:\Users\marco\Documents\projects\dextro\ALLPRINT-CAPBOARD\ALLPRINT-CAPBOARD-677512\ALLPRINT-CAPBOARD-677512-HEAD-BOARD-COMM.SchDoc

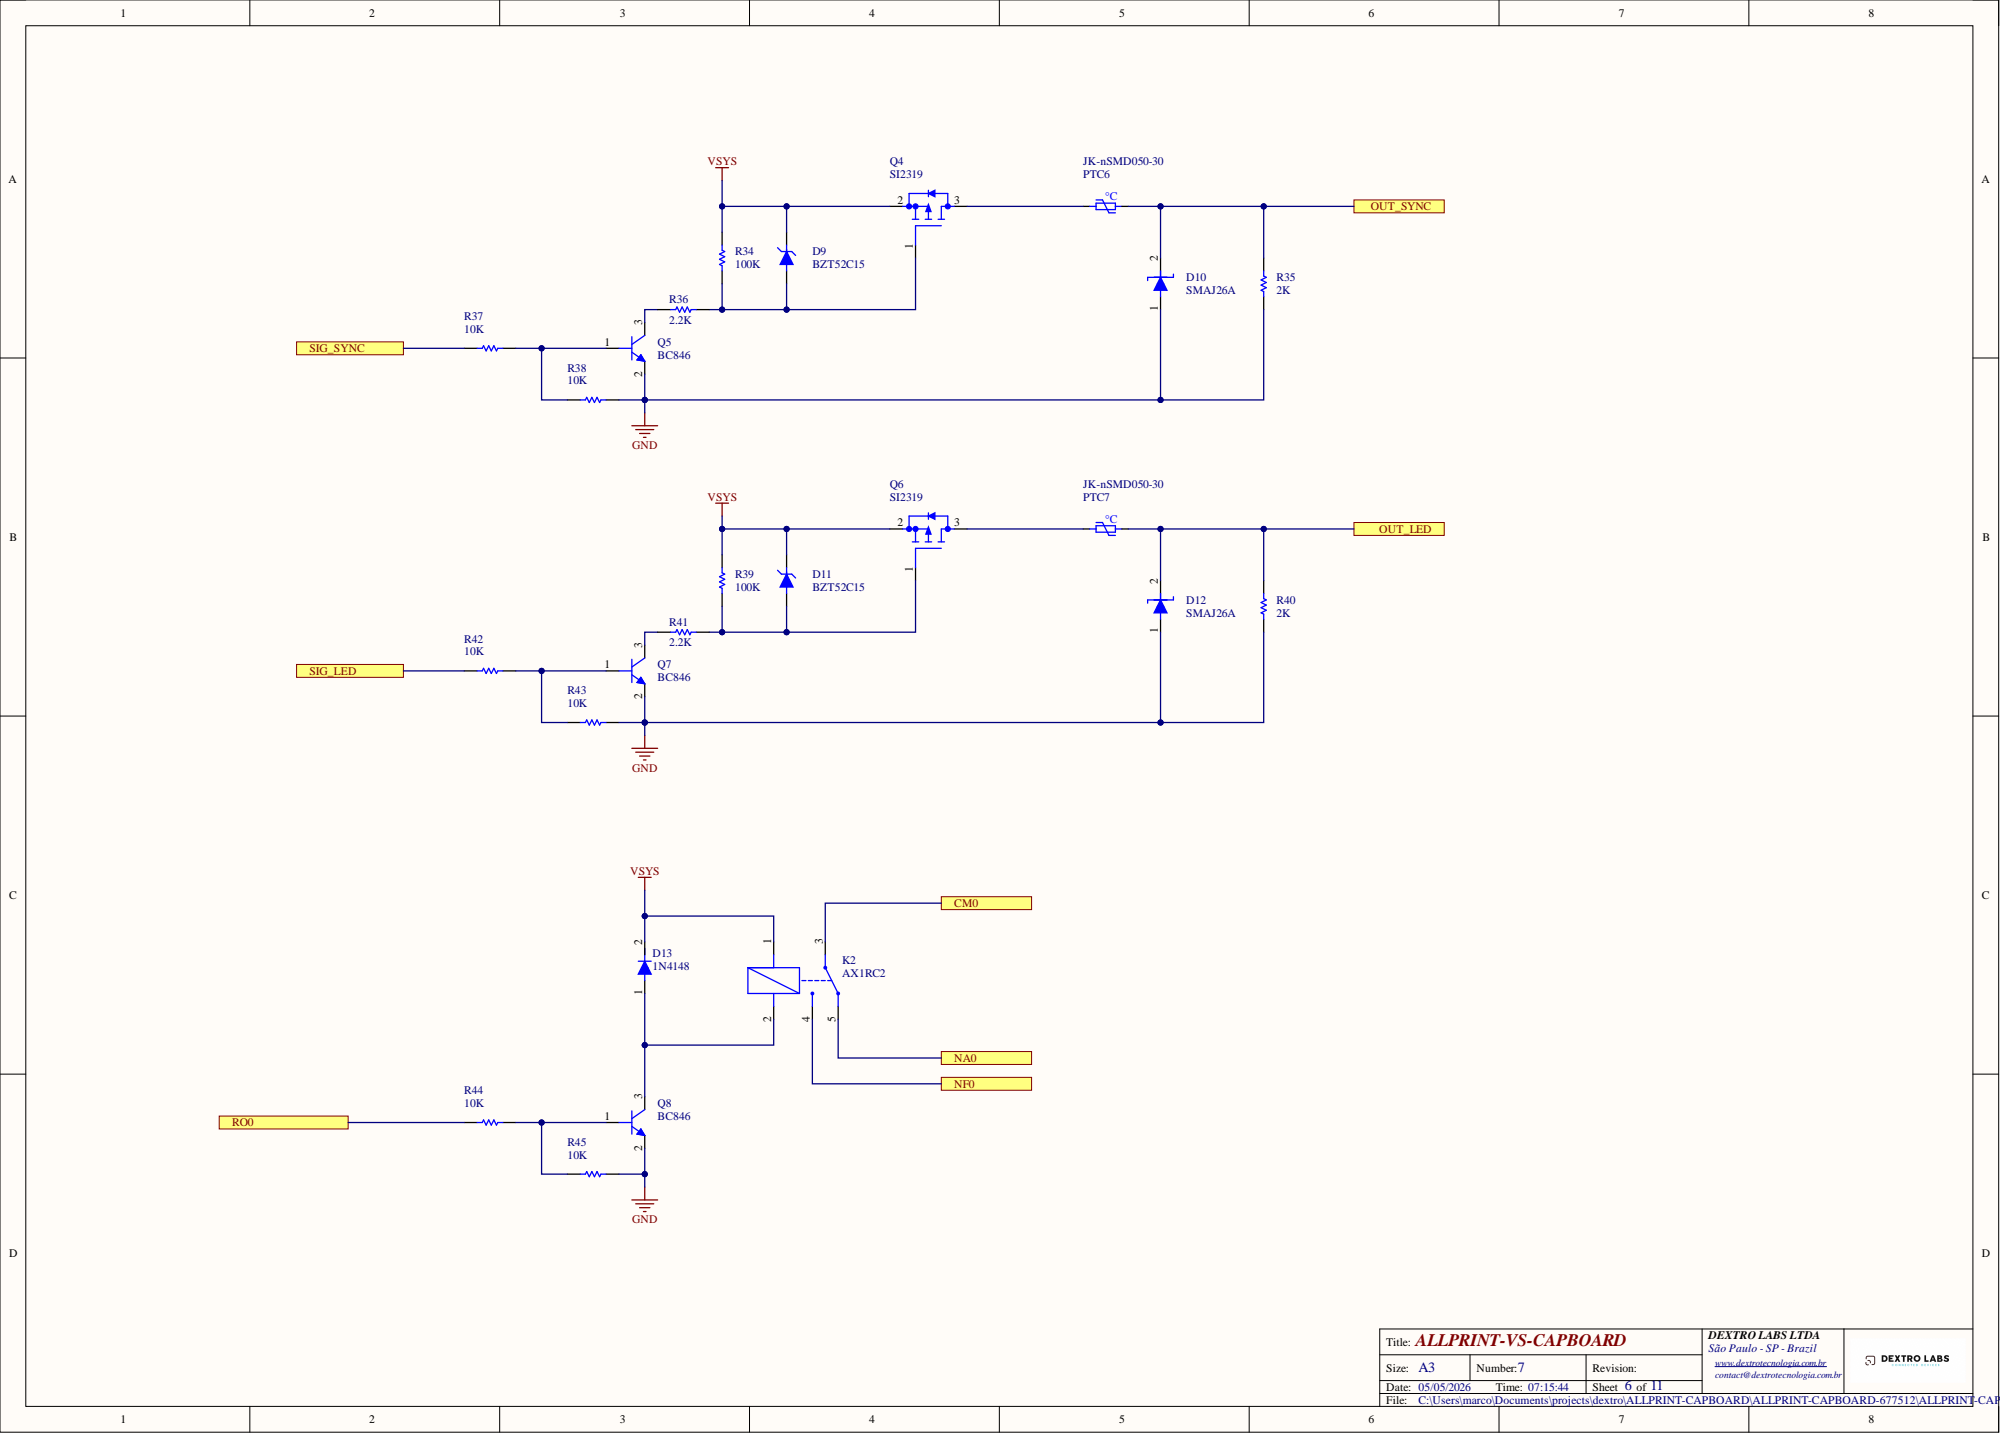
[picture p7: page 6]

C:\Users\marco\Documents\projects\dextro\ALLPRINT-CAPBOARD\ALLPRINT-CAPBOARD-677512\ALLPRINT-CAPBOARD-677512-SIGNAL-OUTPUTS.SchDoc

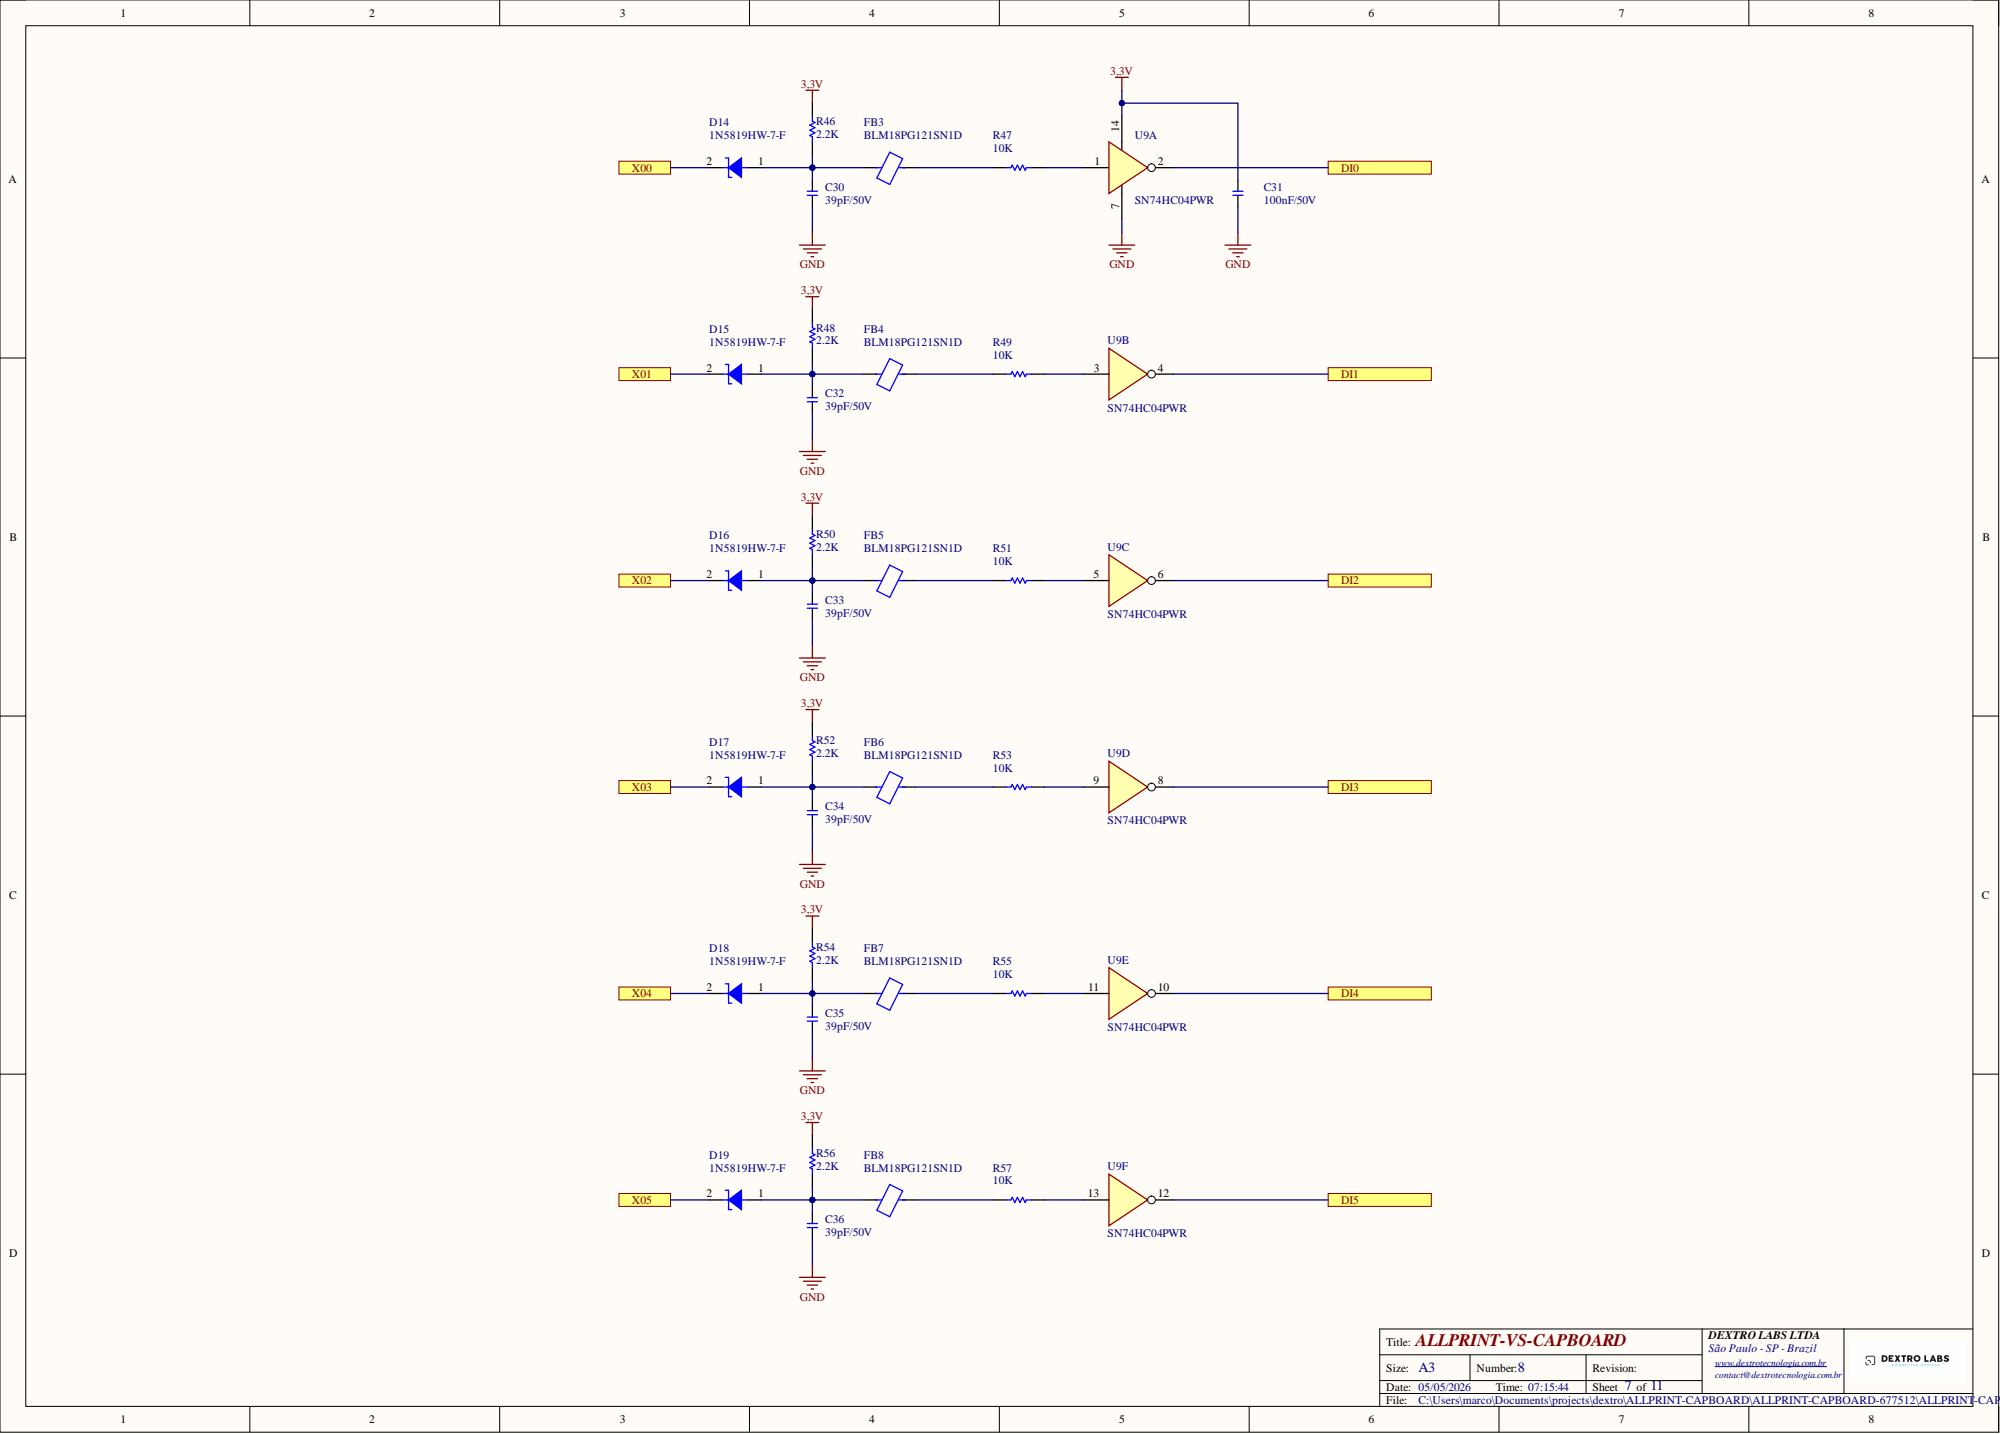
[picture p8: page 7]

C:\Users\marco\Documents\projects\dextro\ALLPRINT-CAPBOARD\ALLPRINT-CAPBOARD-677512\ALLPRINT-CAPBOARD-677512-SIGNAL-INPUTS.SchDoc

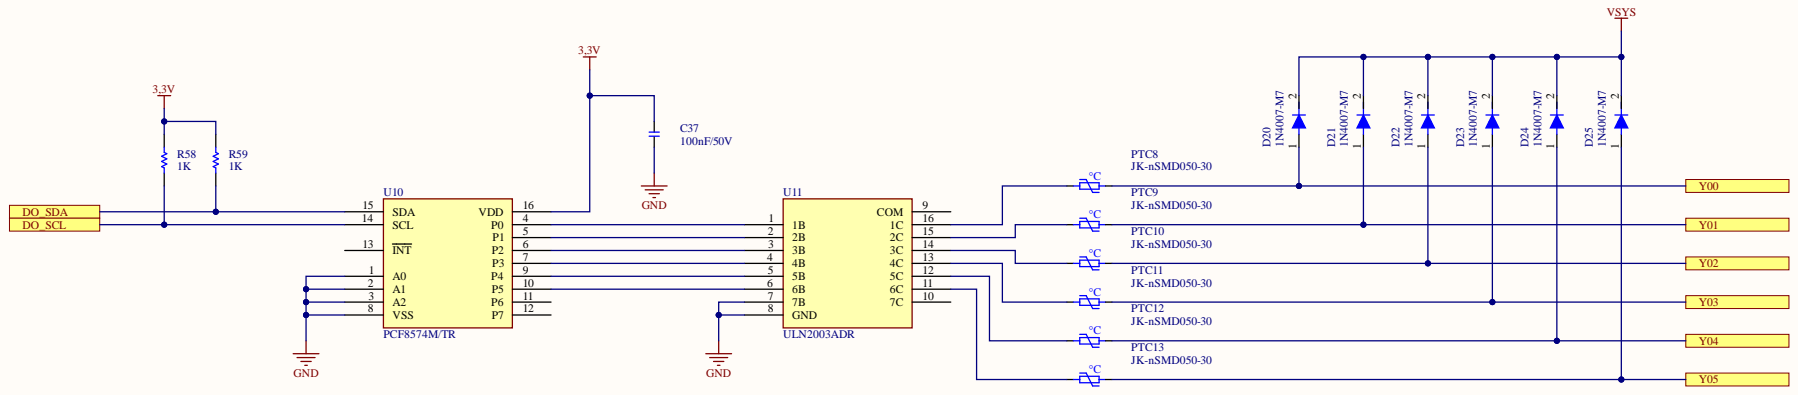
[picture p9: page 8]

PT C 8 J K-nSMD 0 5 0 -3 0

PT C 9 J K-nSMD 0 5 0 -3 0

6 3 | 1 4
7 4 | 1 3

2 | 1 0 6 | 1 1
3 | 1 1 7 | 1 0

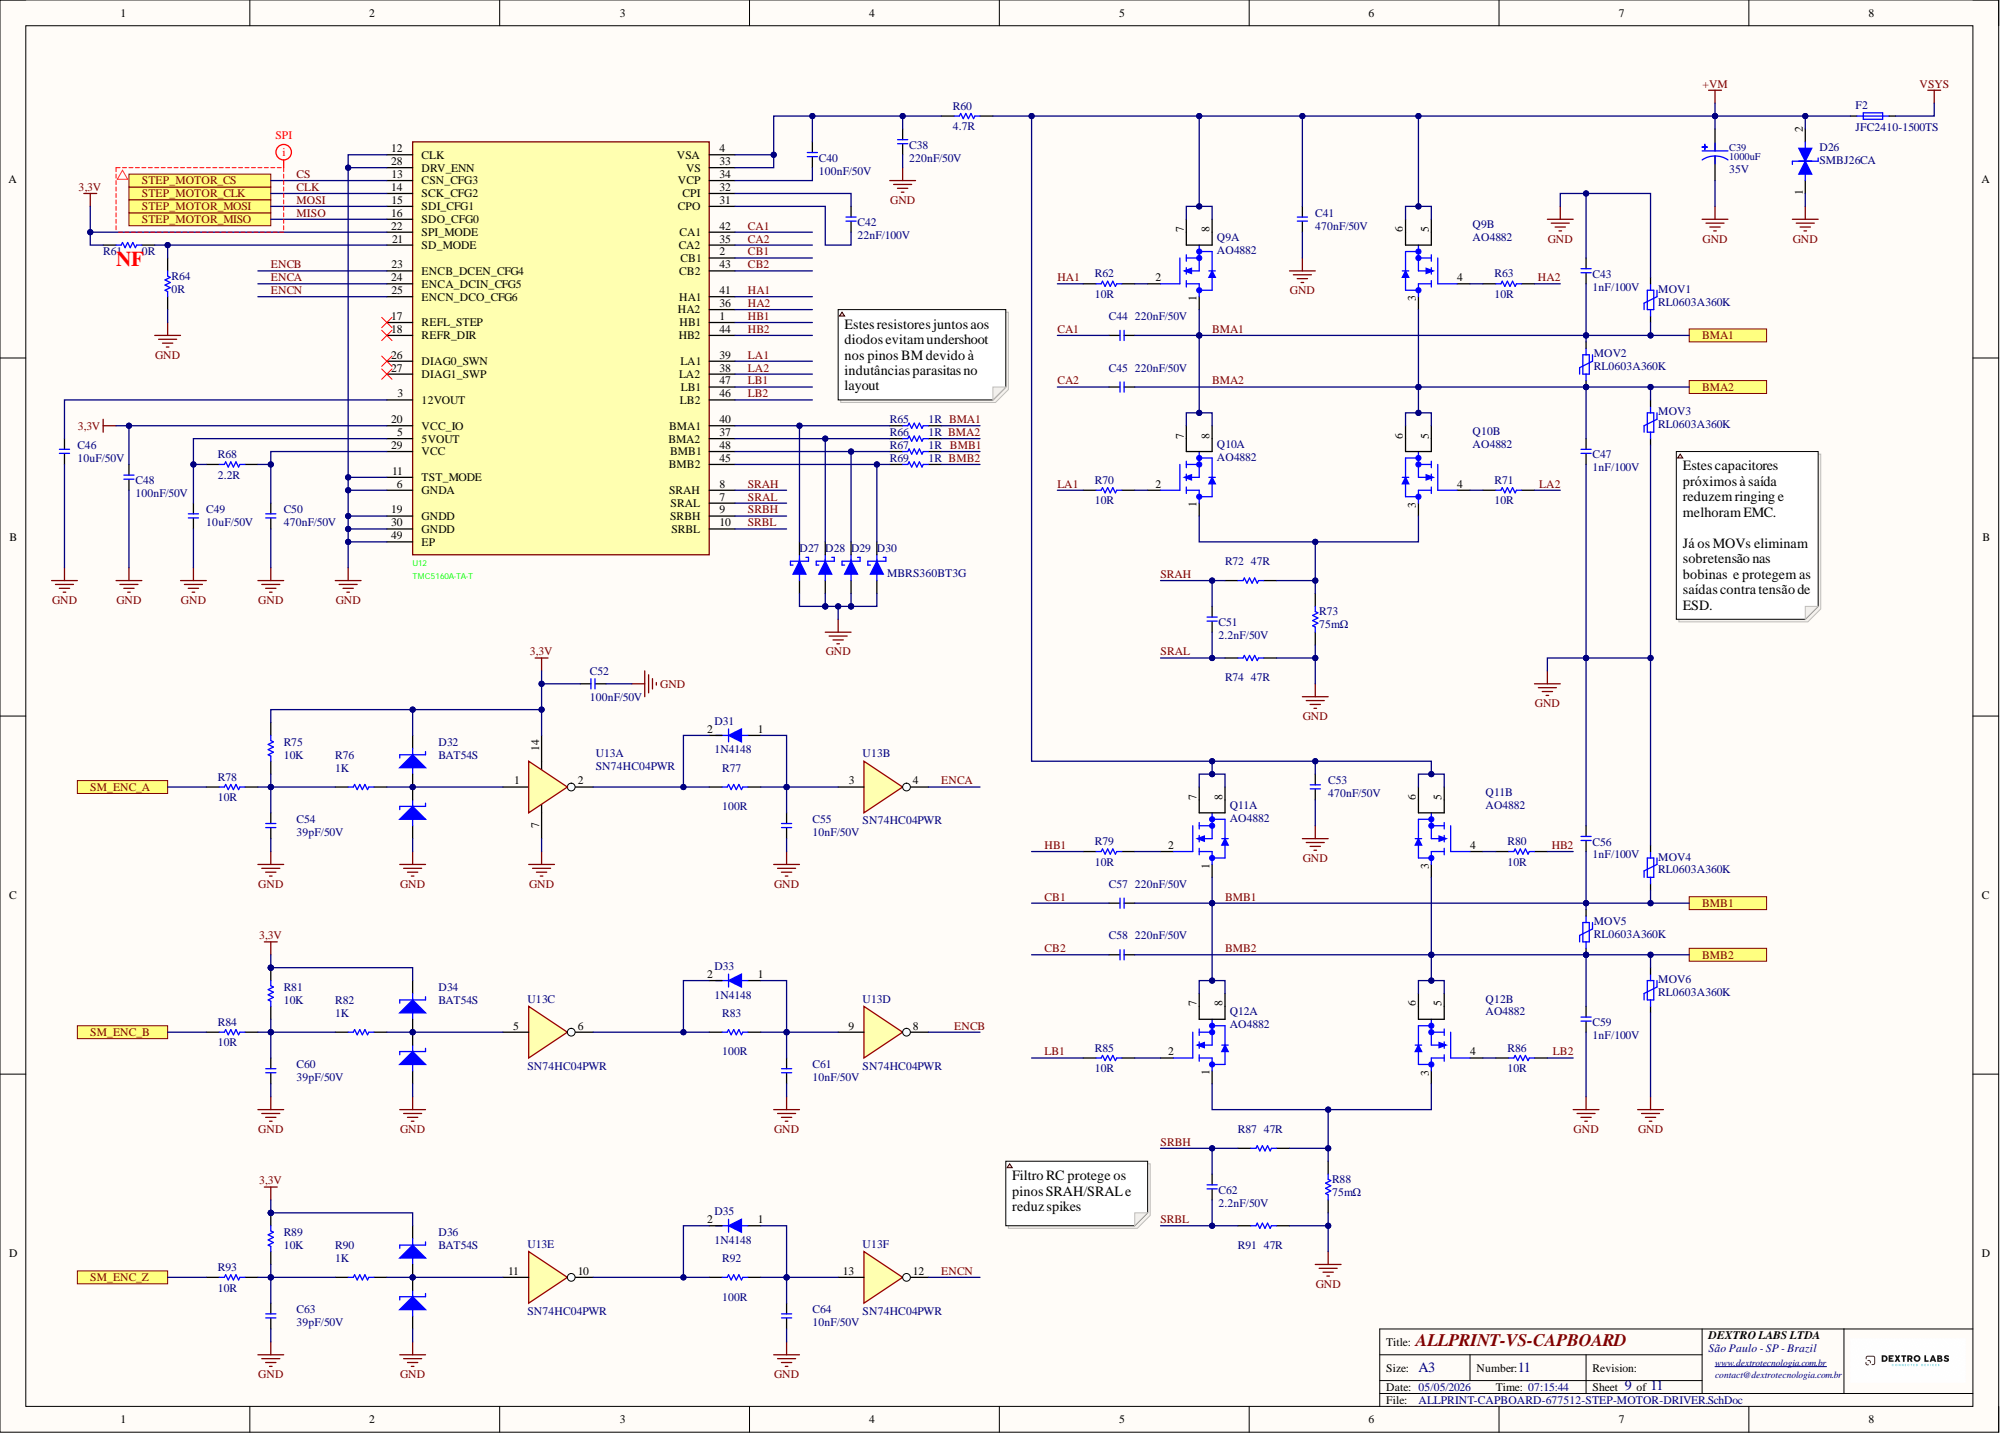
[picture p10: page 9]

2 8
1 3

CL K | 1 4
MOSI | 1 5 | | 3
MISO | | 1 6 | 4 2 | CA 1

2 0 | | 4 0
5 | | 3 7 | R6

2 9 | | 4 8 | | R6
1 1 | | 4 5 | | | R6

2.2 R | | | | 7 SRAH 8 SRA H

3 0 | 1 0 SRBL
4 9

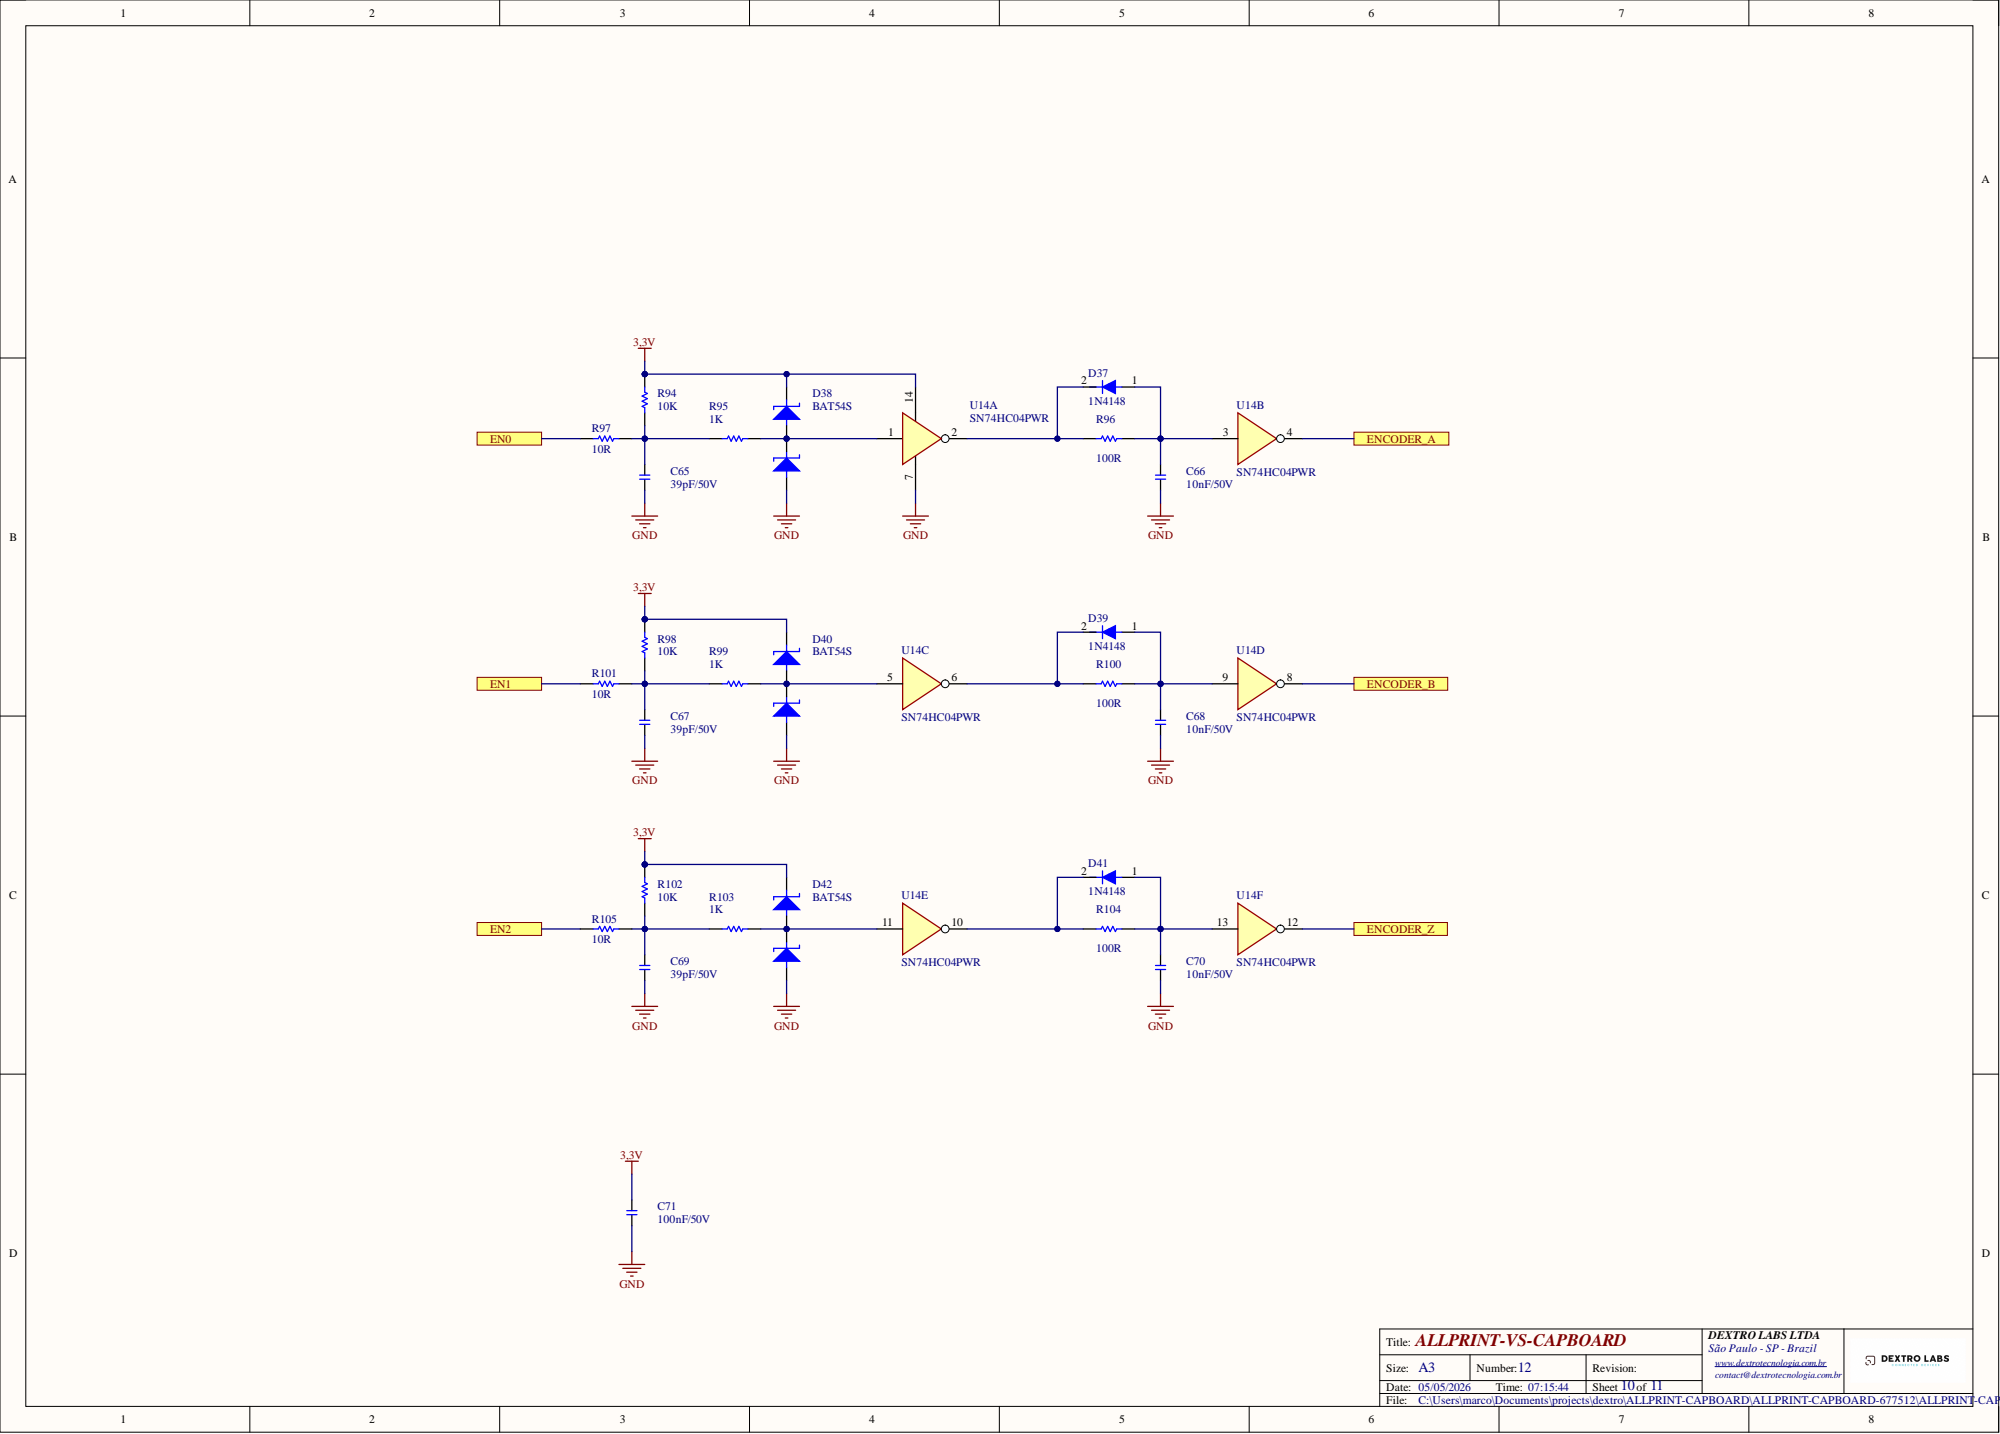
[picture p11: page 10]

C:\Users\marco\Documents\projects\dextro\ALLPRINT-CAPBOARD\ALLPRINT-CAPBOARD-677512\ALLPRINT-CAPBOARD-677512-ENCODER-INPUT.SchDoc

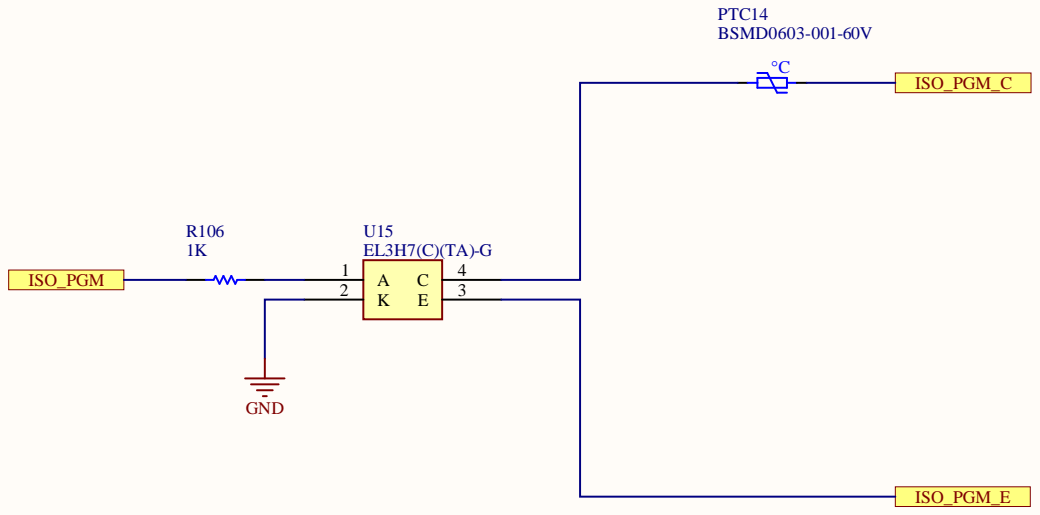
[picture p12: page 11]
