marcosdxt/allprint-capboard/(list of files, drawings)

Other design files:
ALLPRINT-CAPBOARD-677512-DIGITAL-OUTPUTS.SchDoc
ALLPRINT-CAPBOARD-677512-ENCODER-INPUT.SchDoc
ALLPRINT-CAPBOARD-677512-GENERAL.SchDoc
ALLPRINT-CAPBOARD-677512-HEAD-BOARD-COMM.SchDoc
ALLPRINT-CAPBOARD-677512-INDEX-INPUTS.SchDoc
ALLPRINT-CAPBOARD-677512-ISO-PGM.SchDoc
ALLPRINT-CAPBOARD-677512-MCU.SchDoc
ALLPRINT-CAPBOARD-677512-POWER.SchDoc
ALLPRINT-CAPBOARD-677512-SIGNAL-INPUTS.SchDoc
ALLPRINT-CAPBOARD-677512-SIGNAL-OUTPUTS.SchDoc
ALLPRINT-CAPBOARD-677512-STEP-MOTOR-DRIVER.SchDoc
ALLPRINT-CAPBOARD-677512.PcbDoc
ALLPRINT-CAPBOARD-677512.PrjPcb
