marcosdxt/allprint-capboard/(commit log)

2026-04-23 chore: first commit
    [ALLPRINT-CAPBOARD-677512-DIGITAL-OUTPUTS.SchDoc, ALLPRINT-CAPBOARD-677512-ENCODER-INPUT.SchDoc, ALLPRINT-CAPBOARD-677512-GENERAL.SchDoc, ALLPRINT-CAPBOARD-677512-HEAD-BOARD-COMM.SchDoc, ALLPRINT-CAPBOARD-677512-INDEX-INPUTS.SchDoc, ALLPRINT-CAPBOARD-677512-ISO-PGM.SchDoc, ALLPRINT-CAPBOARD-677512-MCU.SchDoc, ALLPRINT-CAPBOARD-677512-POWER.SchDoc]
2026-04-27 primeira versao do layout
    [ALLPRINT-CAPBOARD-677512-DIGITAL-OUTPUTS.SchDoc, ALLPRINT-CAPBOARD-677512-ENCODER-INPUT.SchDoc, ALLPRINT-CAPBOARD-677512-GENERAL.SchDoc, ALLPRINT-CAPBOARD-677512-HEAD-BOARD-COMM.SchDoc, ALLPRINT-CAPBOARD-677512-INDEX-INPUTS.SchDoc, ALLPRINT-CAPBOARD-677512-ISO-PGM.SchDoc, ALLPRINT-CAPBOARD-677512-MCU.SchDoc, ALLPRINT-CAPBOARD-677512-POWER.SchDoc]
2026-05-05 feat: adiciona os arquivos de documentação para fabricação
    [ALLPRINT-CAPBOARD-677512-DIGITAL-OUTPUTS.SchDoc, ALLPRINT-CAPBOARD-677512-ENCODER-INPUT.SchDoc, ALLPRINT-CAPBOARD-677512-GENERAL.SchDoc, ALLPRINT-CAPBOARD-677512-HEAD-BOARD-COMM.SchDoc, ALLPRINT-CAPBOARD-677512-INDEX-INPUTS.SchDoc, ALLPRINT-CAPBOARD-677512-ISO-PGM.SchDoc, ALLPRINT-CAPBOARD-677512-MCU.SchDoc, ALLPRINT-CAPBOARD-677512-POWER.SchDoc]
2026-05-05 feat: ajustes para produção
    [ALLPRINT-CAPBOARD-677512.GBL, ALLPRINT-CAPBOARD-677512.GBO, ALLPRINT-CAPBOARD-677512.GBP, ALLPRINT-CAPBOARD-677512.GBS, ALLPRINT-CAPBOARD-677512.GTL, ALLPRINT-CAPBOARD-677512.GTO, ALLPRINT-CAPBOARD-677512.GTP, ALLPRINT-CAPBOARD-677512.GTS]
2026-05-05 chore: adiciona as documentações de fabricação
    [ALLPRINT-CAPBOARD-677512.GBL, ALLPRINT-CAPBOARD-677512.GBO, ALLPRINT-CAPBOARD-677512.GBP, ALLPRINT-CAPBOARD-677512.GBS, ALLPRINT-CAPBOARD-677512.GTL, ALLPRINT-CAPBOARD-677512.GTO, ALLPRINT-CAPBOARD-677512.GTP, ALLPRINT-CAPBOARD-677512.GTS]
2026-05-05 chore adiciona os arquivos gerber
